sfuphantom/BSPD/README.md

# Break System Plausibility Device

Information will be filled soon. Please check the schematic and layout below.

<object data="BSPD.pdf" type="application/pdf" width="700px" height="700px">
    <embed src="BSPD.pdf">
        <p>This browser does not support PDFs. Please download the PDF to view it: <a href="http://yoursite.com/the.pdf">Download PDF</a>.</p>
    </embed>
</object>
