sfuphantom/BSPD/Project Outputs for BSPD/BSPD_REV2-BOM.xlsx

Sheet: BOM Report
Bill of Materials |  |  | Bill of Materials for BOM Document [BSPD.BomDoc]
Source Data From: |  | BSPD.BomDoc
Project: |  | BSPD.PrjPCB
Variant: |  | None
Creation Date: | 2/04/20 | 4:34 PM
Print Date: | 2020-02-04 | 16:34:37
Footprint | Name | LibRef | Designator | Description | Quantity
C0805 | 10uF | CL21A106KPFNNNG | C1, C2 | Cap Ceramic 10uF 10V X5R 10% SMD 0805 85C Embossed T/R | 2
TLV3201AIDCK | TLV3201AIDCKR | TLV3201AIDCKR | U4 | Comparator Single R-R I/P 5.5V 5-Pin SC-70 T/R | 1
SN74LVC2G08DCUR | SN74LVC2G08DCU | SN74LVC2G08DCUR | U3 | Dual 2-Input Positive-AND Gate | 1
ERBRE-0603 | 500mA | ERB-RE0R50V | F1, F2 | FUSE BOARD MNT 500MA 32VDC 0603 | 2
MOLEX_2PIN | MOLEX2PIN | 43650-0200 | J2 | Headers & Wire Housings R/A HEADER 2 POS TIN SINGLE ROW | 1
TLV3202AIDGK | TLV3202AIDGK | TLV3202AIDGK | U1 | IC COMPAR PWR RRI DL PP 8VSSOP | 1
LED_0603 | PWR | LTST-C191KGKT | D1 | LED GREEN CLEAR SMD | 1
LED_0603 | FLT | LTST-C191KRKT | D2 | LED RED CLEAR SMD | 1
MOLEX_4PIN | MOLEX4PIN | 43650-0400 | J1 | MOLEX 43650-0400 Wire-To-Board Connector, Micro-Fit 3.0 43650 Series, Solder, Header, 4 Contacts, 3 mm | 1
MOSFET | MOSFET-N | BSS138LT3G | Q1 | MOSFET N-CH 50V 200MA SOT-23 | 1
RESC2013X12N | 50k | PTN0805E5002BST1 | R6 | RES 50K OHM 0.1% 1/5W 0805 | 1
R0805 | 2K | ERA6AEB202V | R7 | RES SMD 2K OHM 0.1% 1/8W 0805 | 1
ERJPB3 | 3.09K | ERJ-PB3B3091V | R1 | RES SMD 3.09K OHM 0.1% 1/5W 0603 | 1
ERJPB3 | 3.3K | ERJ-PB3B3301V | R2 | RES SMD 3.3K OHM 0.1% 1/5W 0603 | 1
R0805 | 3.48K | ERA-6AEB3481V | R5 | RES SMD 3.48K OHM 0.1% 1/8W 0805 | 1
R0805 | 5.23K | ERA6AEB5231V | R11 | RES SMD 5.23K OHM 0.1% 1/8W 0805 | 1
R0805 | 6.04K | ERA6AEB6041V | R8 | RES SMD 6.04K OHM 0.1% 1/8W 0805 | 1
R0805 | 10K | ERA6AEB103V | R3, R12 | RES SMD 10K OHM 0.1% 1/8W 0805 | 2
RESC2012X07N | 150 | ERJ6ENF1500V | R9, R10 | RES SMD 150 OHM 1% 1/8W 0805 | 2
R0805 | 499 | ERA-6AEB4990V | R4 | RES SMD 499 OHM 0.1% 1/8W 0805 | 1
SN74AHC1G04DCK | SN74AHC1G04DCK | SN74AHC1G04DCK | U2, U5 | The SN74AHC1G04 contains one inverter gate. The device performs the Boolean function Y = A bar. | 2
 |  |  |  |  | 26
Approved |  | Notes

Sheet: Project Information
Project Full Path | C:\Users\Faraz\Documents\SFU\Team Phantom\BSPD\BSPD.PrjPCB
Project Filename | BSPD.PrjPCB
Variant Name | None
Data-Source Filename | BSPD.BomDoc
Data-Source Full Path | C:\Users\Faraz\Documents\SFU\Team Phantom\BSPD\BSPD.BomDoc
Title | Bill of Materials for BOM Document [BSPD.BomDoc]
Total Quantity | 26
Report Time | 4:34 PM
Report Date | 2/04/20
Report Date & Tine | 2/04/20 4:34 PM
Output Name | Bill of Materials
Output Type | BOM_PartType
Output Generator Name | BOM
Output Generator Description | Bill of Materials
