sfuphantom/BSPD/Project Outputs for BSPD/BSPD_REV2.step

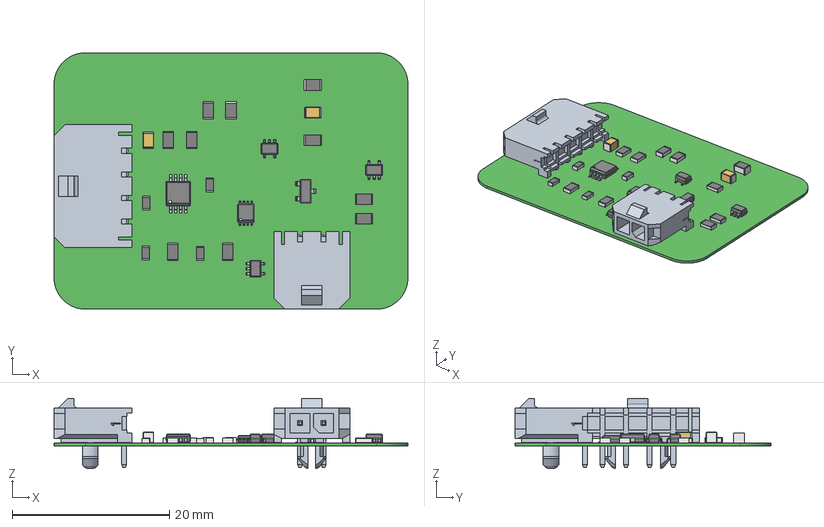
[picture p1: CAD file, 2020-02-05]
Project Outputs for BSPD/BSPD_REV2.step
45.0 x 32.6 x 8.91 mm
Mid_Body x 14
Open_CASCADE_STEP_translator_6.8_7.2.1 x 4
Mark x 14
Open_CASCADE_STEP_translator_6.8_5.2.1 x 4
Open_CASCADE_STEP_translator_6.8_1.1.1 x 2
Leader x 34
Open_CASCADE_STEP_translator_6.8_1.2.1 x 14
Open_CASCADE_STEP_translator_6.8_2.1.1 x 2
Open_CASCADE_STEP_translator_6.8_2.1.2 x 2
Open_CASCADE_STEP_translator_6.8_2.2.1 x 6
Open_CASCADE_STEP_translator_6.8_3.1
Open_CASCADE_STEP_translator_6.8_3.2.1
Open_CASCADE_STEP_translator_6.8_23.1.1
Open_CASCADE_STEP_translator_6.8_6.2.1 x 3
Open_CASCADE_STEP_translator_6.8_6.1
Open_CASCADE_STEP_translator_6.8_17.1.1
