sfuphantom/BSPD/Data Sheets/436500200.stp

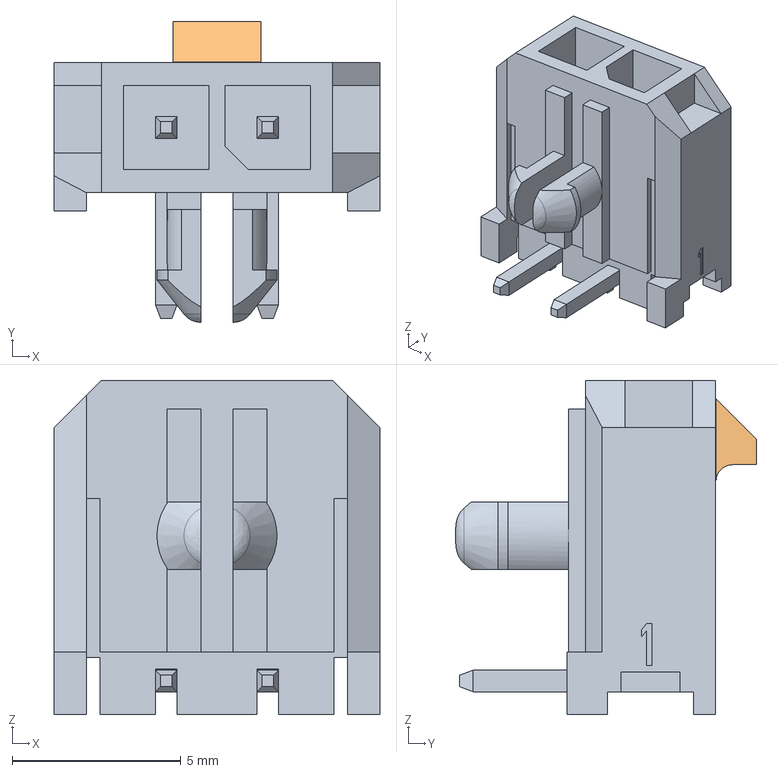
[picture p2: CAD file, 2019-08-26]
Data Sheets/436500200.stp
9.65 x 8.91 x 9.90 mm
