sfuphantom/BSPD/Data Sheets/436500400.stp

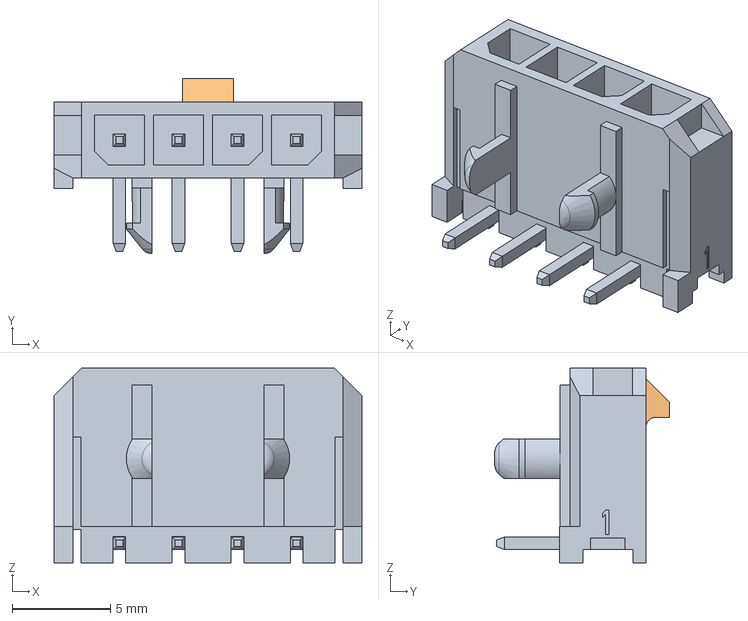
[picture p3: CAD file, 2019-08-26]
Data Sheets/436500400.stp
15.7 x 8.91 x 9.90 mm
