sfuphantom/BSPD/(list of files, cad)

Other CAD files:
Project Outputs for BSPD/BSPD.step
