sfuphantom/BSPD/BSPD_Eagle_Schematic.pdf

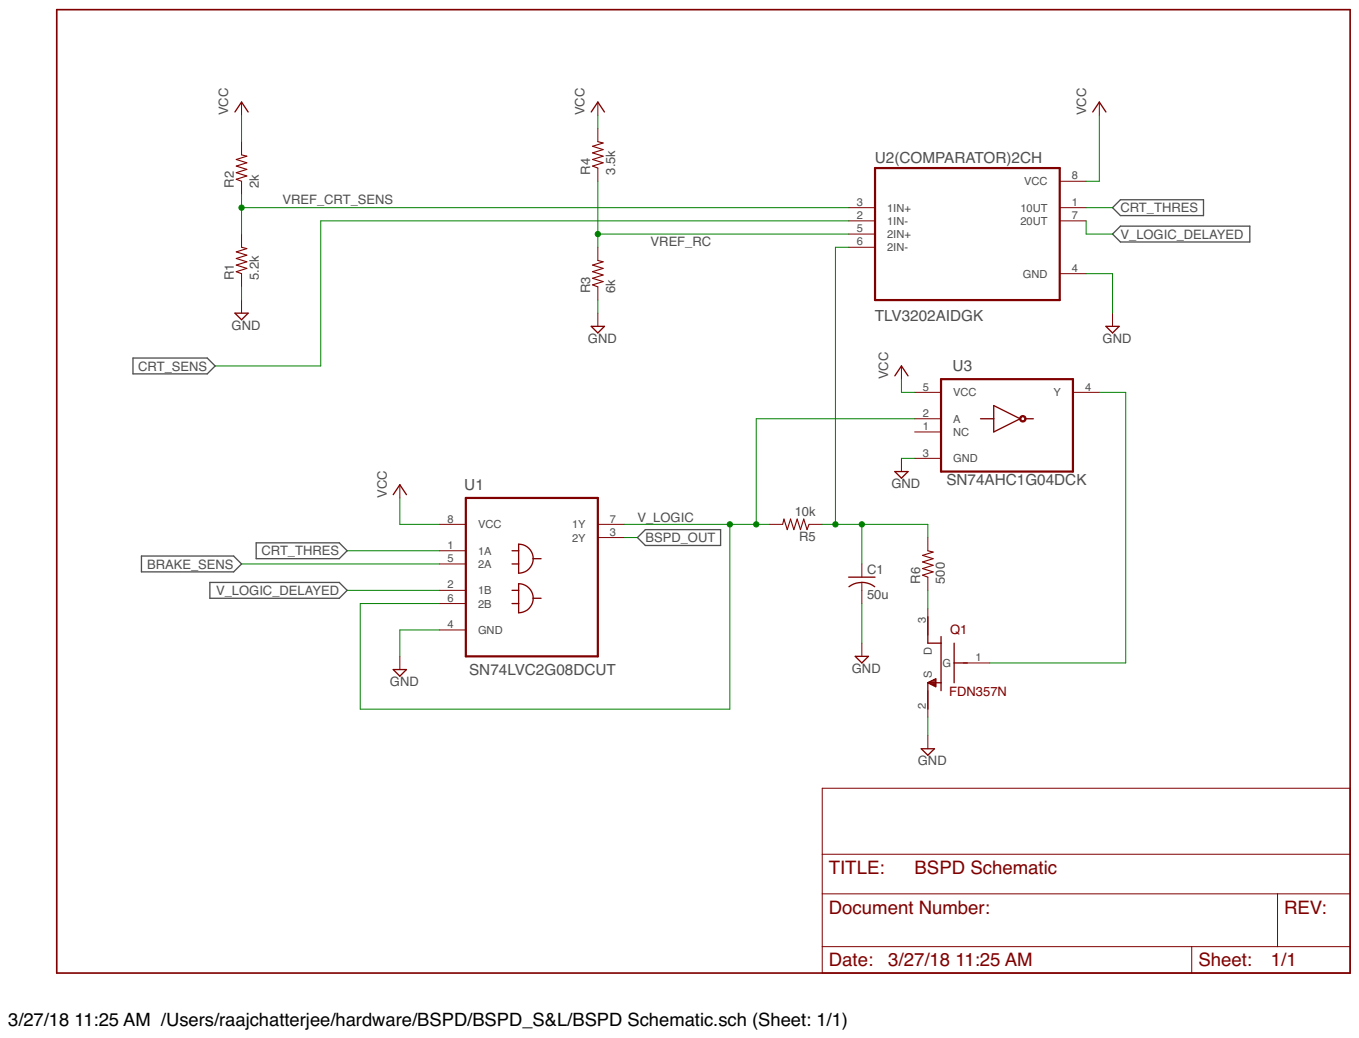
[picture p4: page 1]

5 | 7 GND 4

Document Number: | REV:

Date: 3/27/18 11:25 AM | Sheet: 1/1

3/27/18 11:25 AM /Users/raajchatterjee/hardware/BSPD/BSPD_S&L/BSPD Schematic.sch (Sheet: 1/1)
