sfuphantom/BSPD/BSPD_S&L/BSPD Schematic.pdf

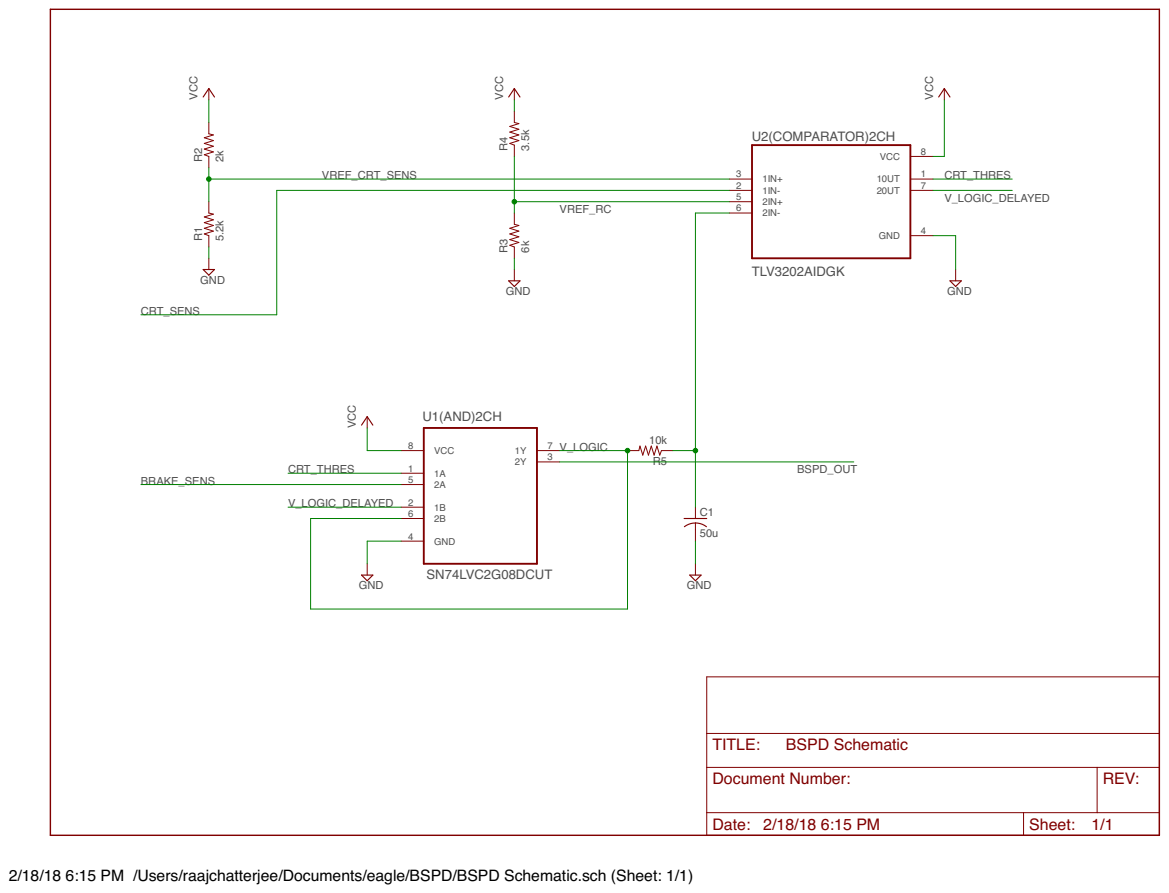
[picture p5: page 1]

1IN- 2

Document Number: | REV:

Date: 2/18/18 6:15 PM | Sheet: 1/1

2/18/18 6:15 PM /Users/raajchatterjee/Documents/eagle/BSPD/BSPD Schematic.sch (Sheet: 1/1)
