sfuphantom/BSPD/BSPD.pdf

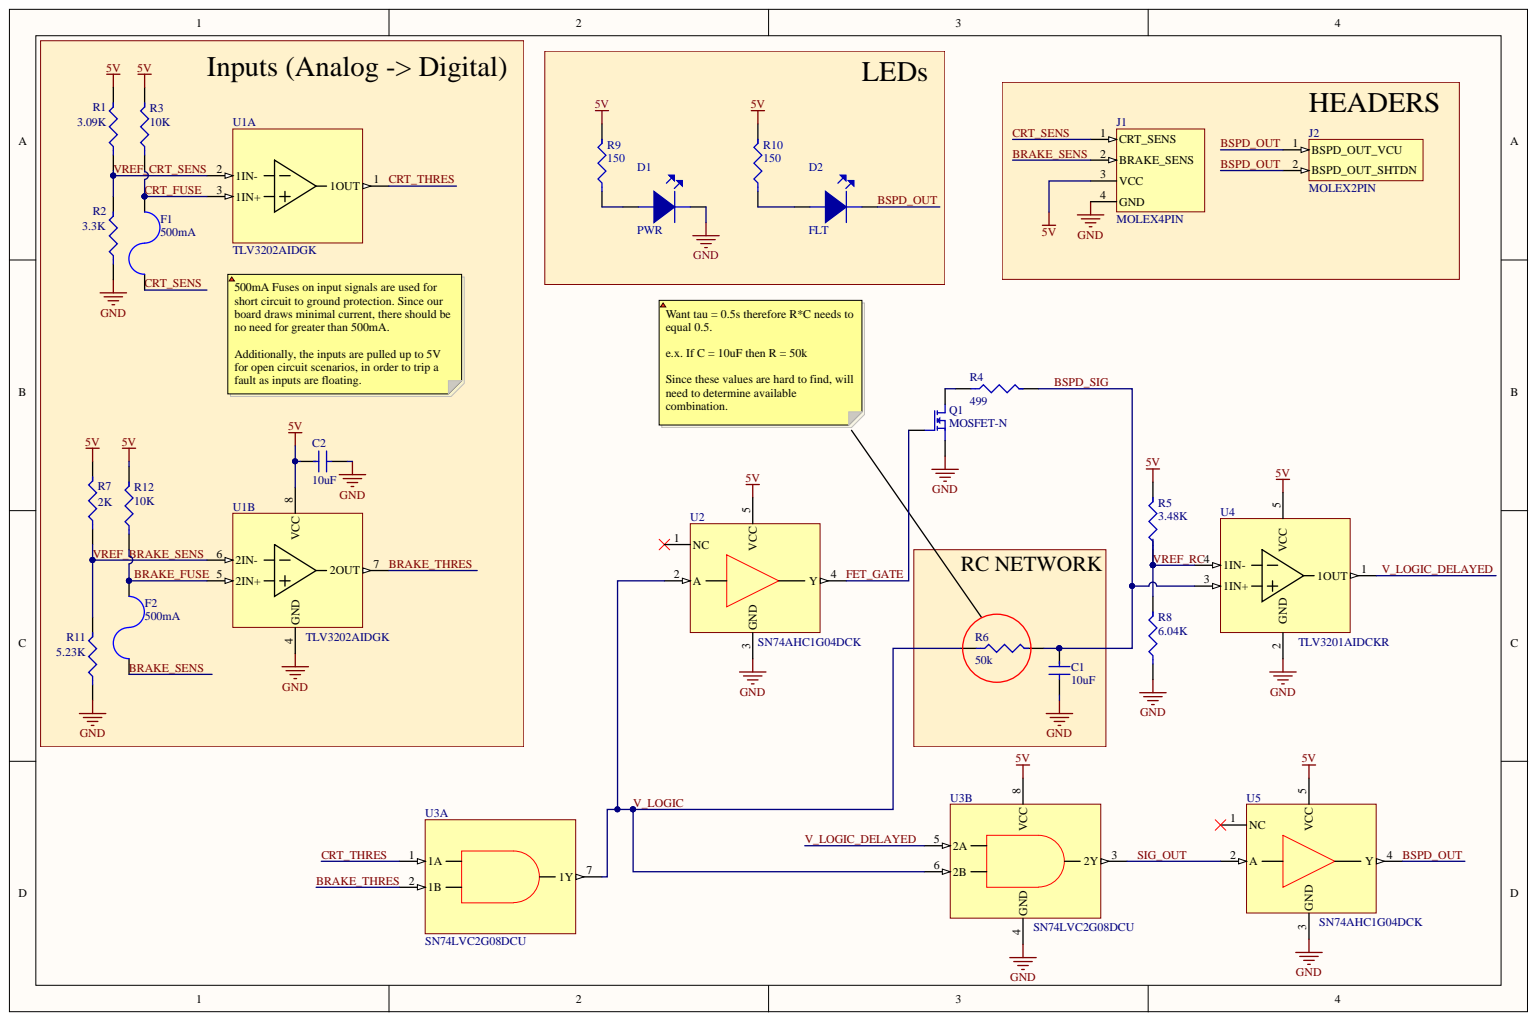
[picture p6: page 1]

500mA Fuses on input signals are used for
short circuit to ground protection. Since our
board draws minimal current, there should be
no need for greater than 500mA.

Want tau = 0.5s therefore R*C needs to
equal 0.5.

Additionally, the inputs are pulled up to 5V
for open circuit scenarios, in order to trip a
fault as inputs are floating.

Since these values are hard to find, will
need to determine available
combination.

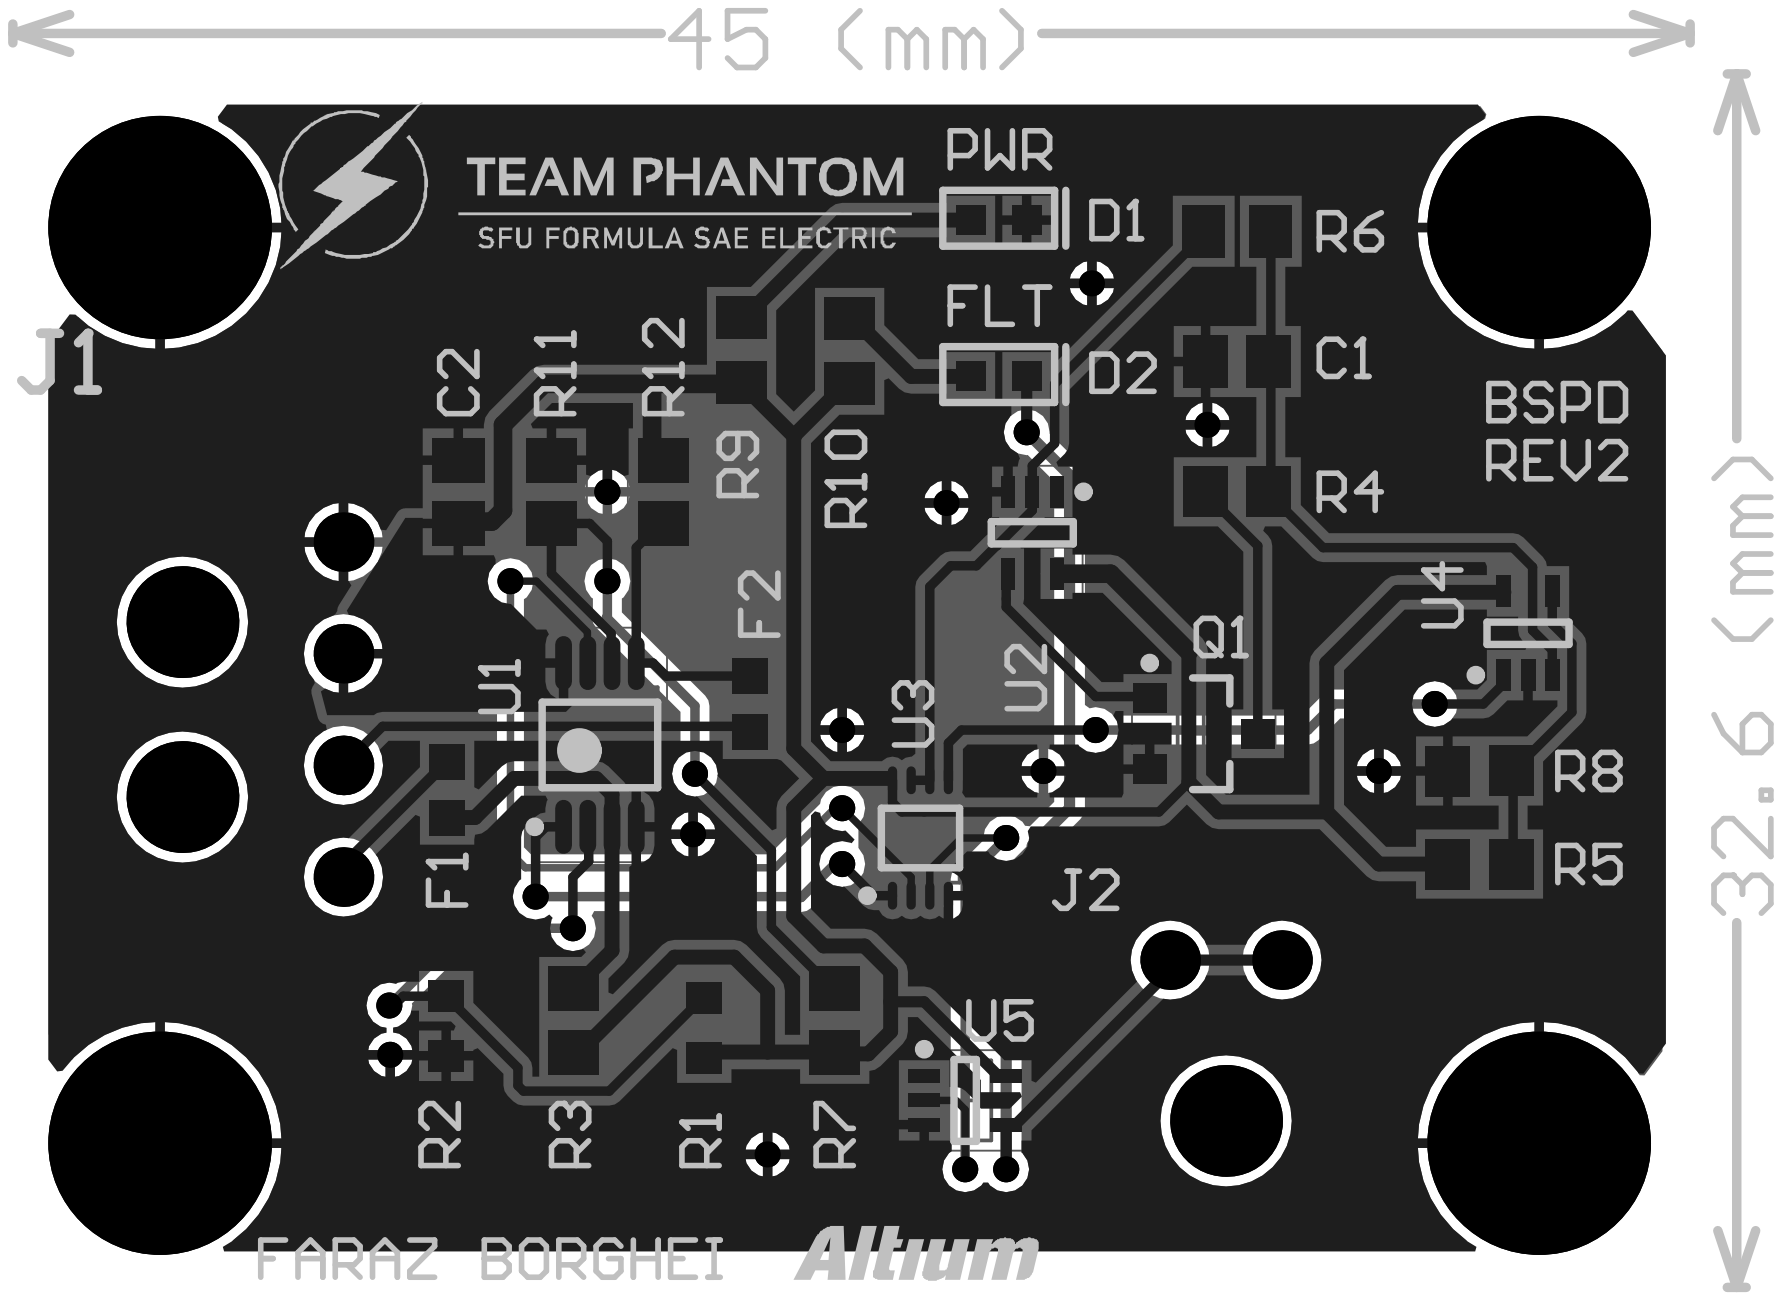
[picture p7: page 2]
