sfuphantom/BSPD/BSPD_REV0.pdf

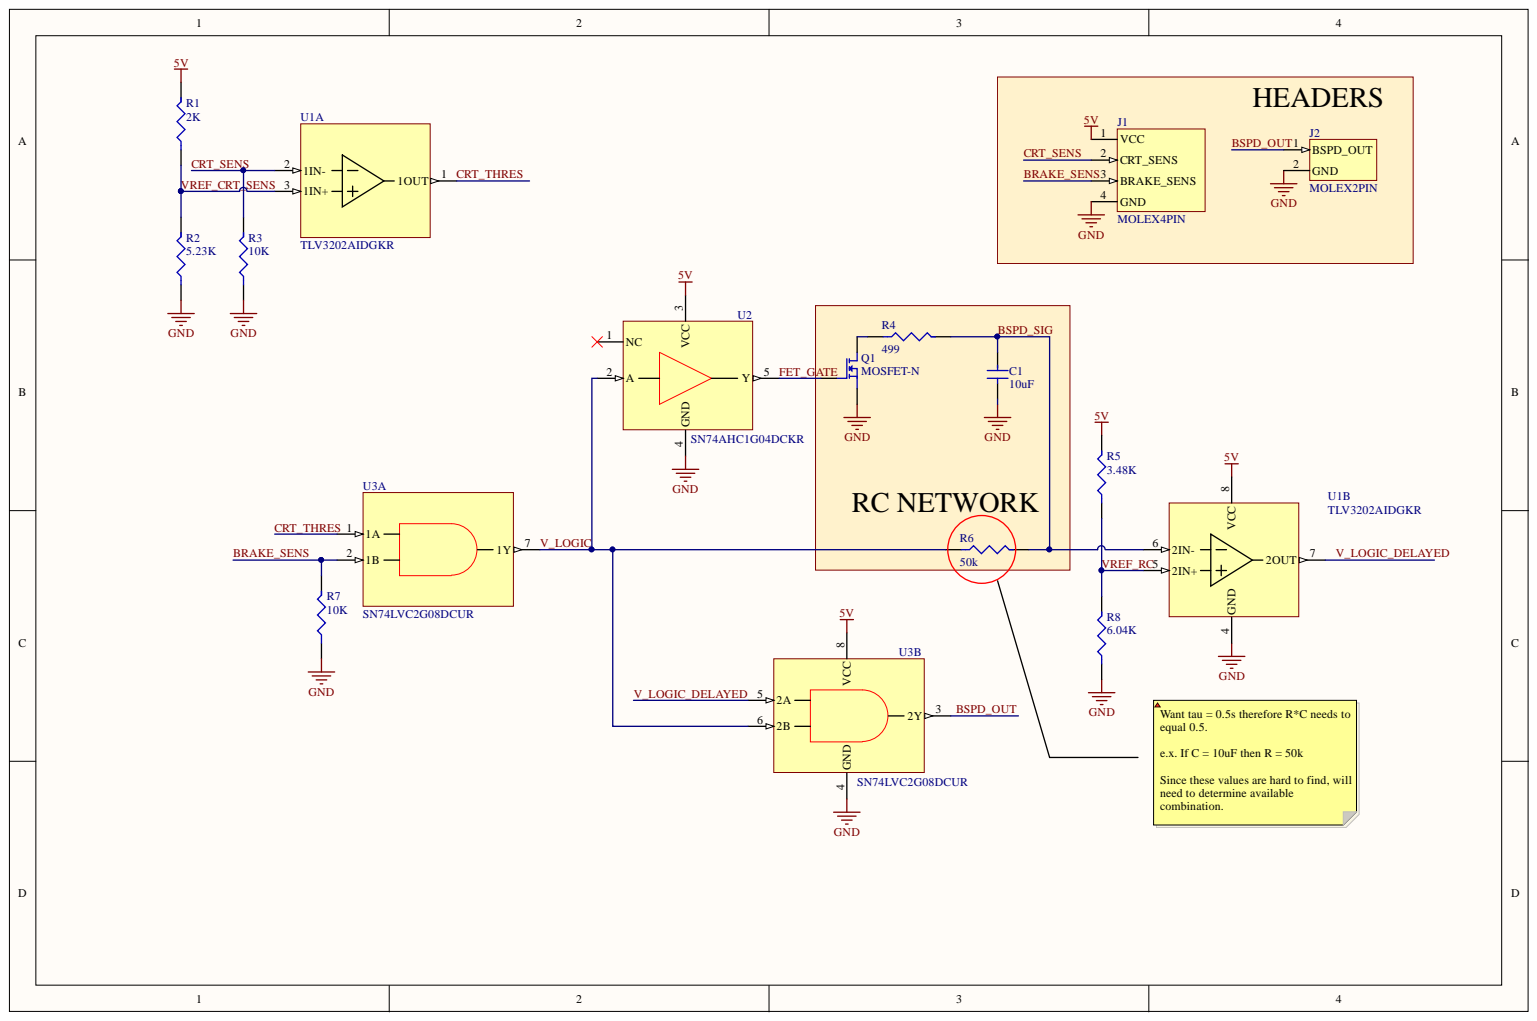
[picture p8: page 1]

Want tau = 0.5s therefore R*C needs to
equal 0.5.

Since these values are hard to find, will
need to determine available
combination.

Bill of Materials | Bill of Materials for Project [BSPD.PrjPCB] (No PCB Document Selected)
Source Data From: | BSPD.PrjPCB
Project: | | BSPD.PrjPCB
Variant: | | None
Creation Date: 2/28/19 | 11:32 PM
Print Date: | 28-Feb-19 | 11:32:22 PM
Footprint | Comment | LibRef | Designator | Description | | Quantity
C0805 | 10uF | CL21A106KPFNNNGC1 | Cap Ceramic 10uF 10V X5R 10% SMD 0805 85C Embossed T/R 1
MOLEX_4PIN | MOLEX4PIN | 43650-0400 | J1 | MOLEX | 43650-0400 | Wire-To-Board Connector, Micro-Fit 3.0 43650 Series, Solder, Header, 4 Contacts, 3 mm 1
MOLEX_2PIN | MOLEX2PIN | 43650-0200 | J2 | Headers & Wire Housings R/A HEADER 2 POS TIN SINGLE ROW 1
MOSFET | MOSFET-N | BSS138LT3G | Q1 | MOSFET N-CH 50V 200MA SOT-23 | 1
R0805 | 2K | ERA6AEB202V | R1 | RES SMD 2K OHM 0.1% 1/8W 0805 | 1
R0805 | 5.23K | ERA6AEB5231V | R2 | RES SMD 5.23K OHM 0.1% 1/8W 0805 | 1
R0805 | 10K | ERA6AEB103V | R3 | RES SMD 10K OHM 0.1% 1/8W 0805 | 1
R0805 | 499 | ERA-6AEB4990V R4 | RES SMD 499 OHM 0.1% 1/8W 0805 | 1
R0805 | 3.48K | ERA6AEB3483V | R5 | RES SMD 348K OHM 0.1% 1/8W 0805 | 1
RESC2013X12N50k | PTN0805E5002BST1 R6 | RES 50K OHM 0.1% 1/5W 0805 | 1
R0805 | 10K | ERA6AEB103V | R7 | RES SMD 10K OHM 0.1% 1/8W 0805 | 1
R0805 | 6.04K | ERA6AEB6041V | R8 | RES SMD 6.04K OHM 0.1% 1/8W 0805 | 1
TLV3202AIDGKTLV3202AIDGKR TLV3202AIDGKR U1 | IC COMPAR PWR RRI DL PP 8VSSOP | 1
SN74AHC1G04DCKR SN74AHC1G04DCKR SN74AHC1G04DCKR U2 | The SN74AHC1G04 contains one inverter
| | | | | | 1
SN74LVC2G08DCUR SN74LVC2G08DCUR SN74LVC2G08DCUR U3 | Dual 2-Input Positive-AND Gate | 1
| | | | | | 15
Approved | | Notes
Altium Limited Confidential | 2/28/19 | Page 1

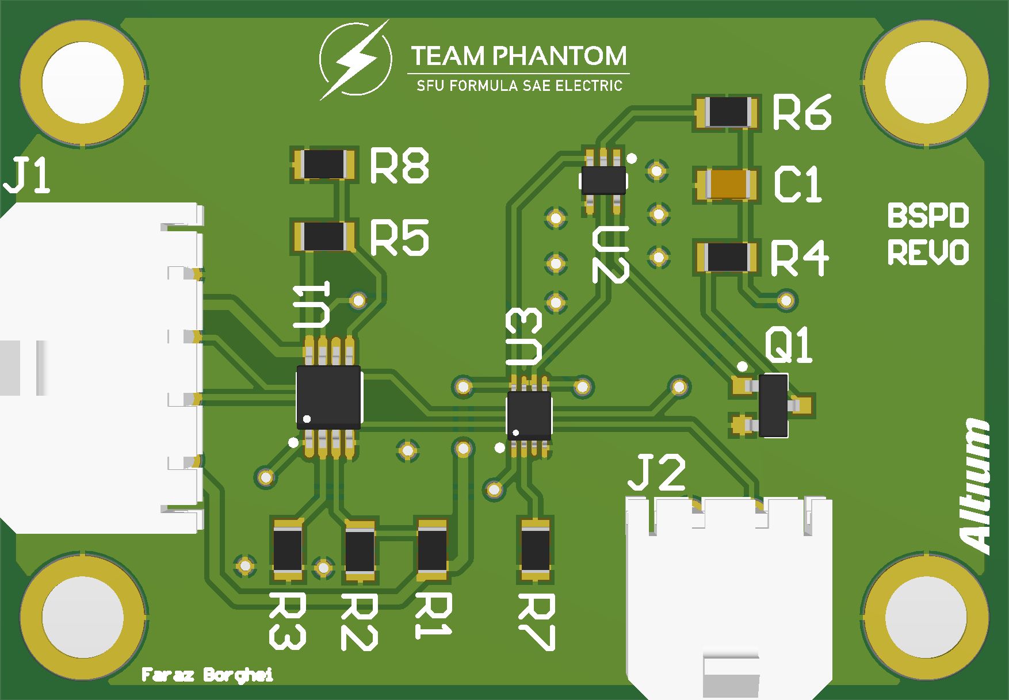
[picture p9: page 3]

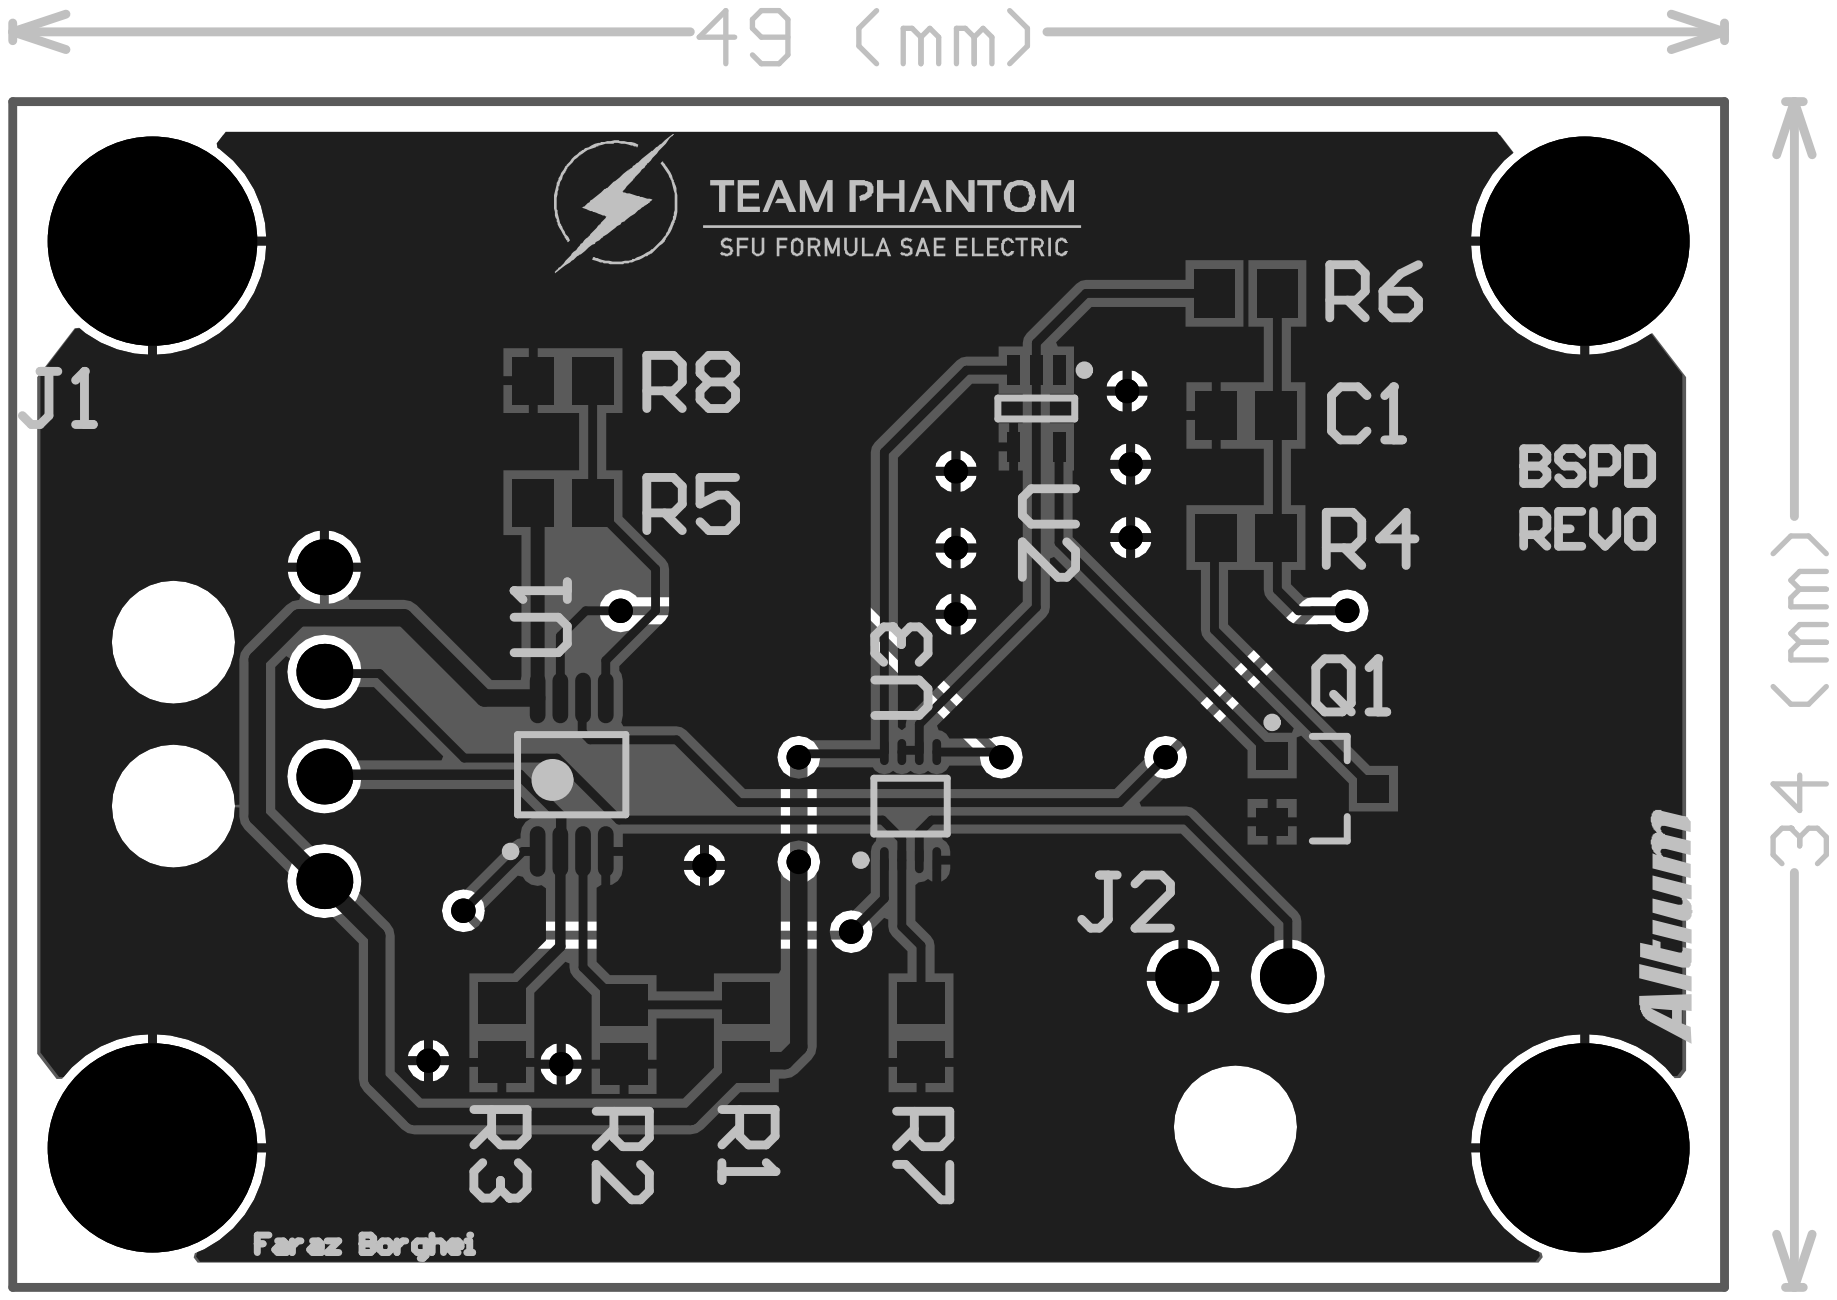
[picture p10: page 4]
