sfuphantom/BSPD/(list of files, drawings)

Other design files:
BSPD.PcbDoc
BSPD.PcbLib
BSPD.PrjPCB
BSPD.SchDoc
BSPD.SchLib
