sfuphantom/BSPD/BSPD_S&L/BSPD Schematic.sch

## EAGLE design BSPD_S&L/BSPD Schematic.sch (2019-08-26)

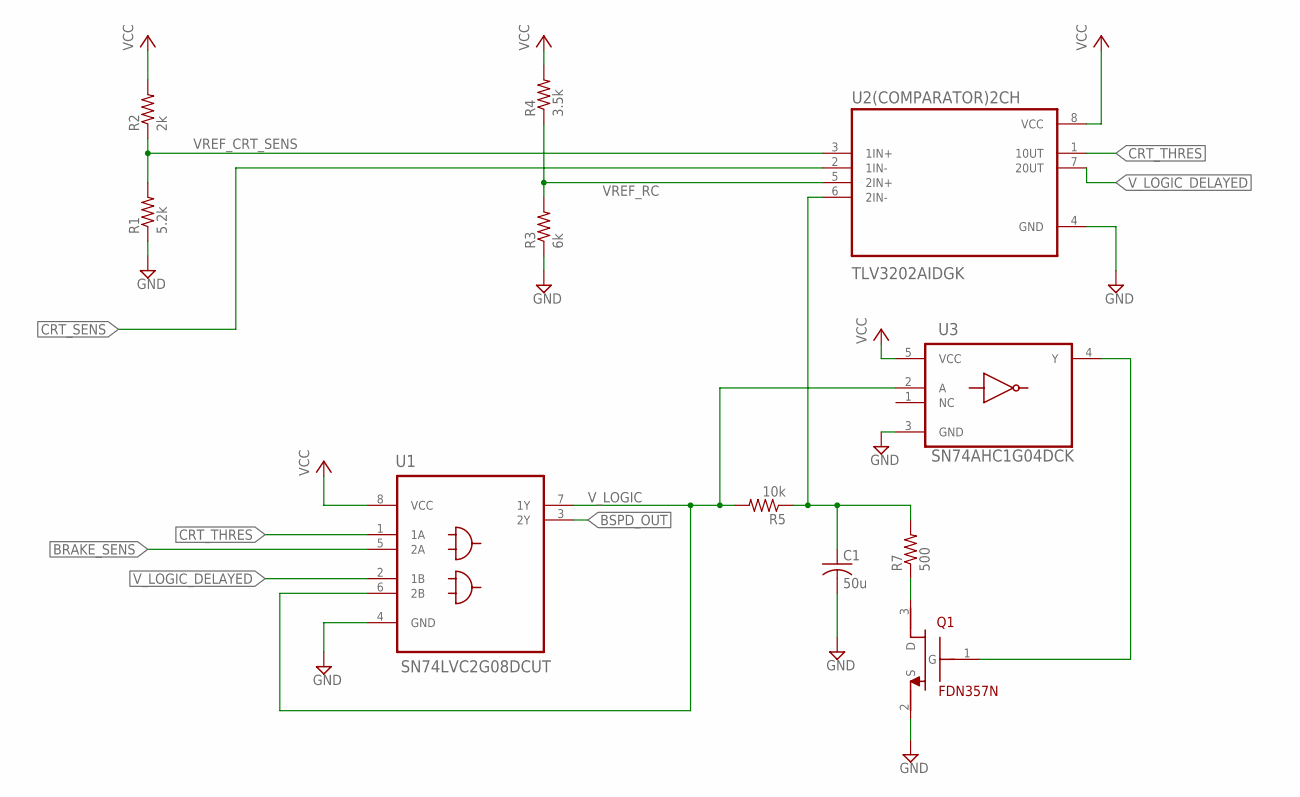
[picture p11: schematic BSPD Schematic.sch]

Parts:
C1: 50u; C0603
Q1: FDN357N; SOT95P280X130-3N
R1: 5.2k; R0603
R2: 2k; R0603
R3: 6k; R0603
R4: 3.5k; R0603
R5: 10k; R0603
R7: 500; R0603
U1: SN74LVC2G08DCUT; SOP50P310X90-8N
U2(COMPARATOR)2CH: TLV3202AIDGK; SOP65P490X110-9N
U3: SN74AHC1G04DCK; SOT65P210X110-5N

Connections:
BRAKE_SENS: U1.5 (2A)
BSPD_OUT: U1.3 (2Y)
CRT_SENS: U2(COMPARATOR)2CH.2 (1IN-)
CRT_THRES: U1.1 (1A), U2(COMPARATOR)2CH.1 (10UT)
GND: C1.2, Q1.2 (S), R1.1, R3.1, U1.4 (GND), U2(COMPARATOR)2CH.4 (GND), U3.3 (GND)
unnamed: C1.1, R5.1, R7.2, U2(COMPARATOR)2CH.6 (2IN-)
unnamed: Q1.3 (D), R7.1
unnamed: Q1.1 (G), U3.4 (Y)
VCC: R2.2, R4.2, U1.8 (VCC), U2(COMPARATOR)2CH.8 (VCC), U3.5 (VCC)
VREF_CRT_SENS: R1.2, R2.1, U2(COMPARATOR)2CH.3 (1IN+)
VREF_RC: R3.2, R4.1, U2(COMPARATOR)2CH.5 (2IN+)
V_LOGIC: R5.2, U1.6 (2B), U1.7 (1Y), U3.2 (A)
V_LOGIC_DELAYED: U1.2 (1B), U2(COMPARATOR)2CH.7 (20UT)
