sfuphantom/BSPD/(commit log)

2019-08-26 Swapped U4 inputs
    [436500200.stp, 436500400.stp, BSPD Schematic.sch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]
2019-09-29 replaced R5 with 3.48K ohm
    [BSPD.step]
2019-12-31 Changed output to active-low and generated gerber and drill files
    [BSPD.DRL, BSPD.GBL, BSPD.GBO, BSPD.GBP, BSPD.GBS, BSPD.GM1, BSPD.GTL, BSPD.GTO]
2020-01-01 changed input pull-down resistors to pull-up
    [BSPD.PcbDoc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]
2020-01-13 changed CRT_SENS voltatge divider and added fuse to inputs
    [BSPD.DRL, BSPD.GBL, BSPD.GBS, BSPD.GKO, BSPD.GTL, BSPD.GTO, BSPD.GTP, BSPD.GTS]
2020-01-13 added fuse to inputs
    [BSPD.DRL, BSPD.GBL, BSPD.GBS, BSPD.GTL, BSPD.GTO, BSPD.GTP, BSPD.GTS]
2020-01-25 rounded board edges
    [BSPD.DRL, BSPD.GBL, BSPD.GBO, BSPD.GBP, BSPD.GBS, BSPD.GKO, BSPD.GM1, BSPD.GTL]
2020-01-26 completed review changes
    [BSPD.DRL, BSPD.GBL, BSPD.GBO, BSPD.GBP, BSPD.GBS, BSPD.GKO, BSPD.GM1, BSPD.GTL]
2020-02-02 generated gerbers
    [BSPD.GBL, BSPD.GBO, BSPD.GBP, BSPD.GBS, BSPD.GKO, BSPD.GM1, BSPD.GTL, BSPD.GTO]
2020-02-05 generated BomDoc
    [BSPD.PrjPCB, BSPD_REV2-BOM.xlsx, BSPD_REV2-BOM_Reduced.xlsx, BSPD_REV2.step]
